oskitone/scout/kicad/keyboard_matrix/keyboard_matrix.kicad_pcb

## KiCad design kicad/keyboard_matrix/keyboard_matrix.kicad_pcb (2021-02-08)

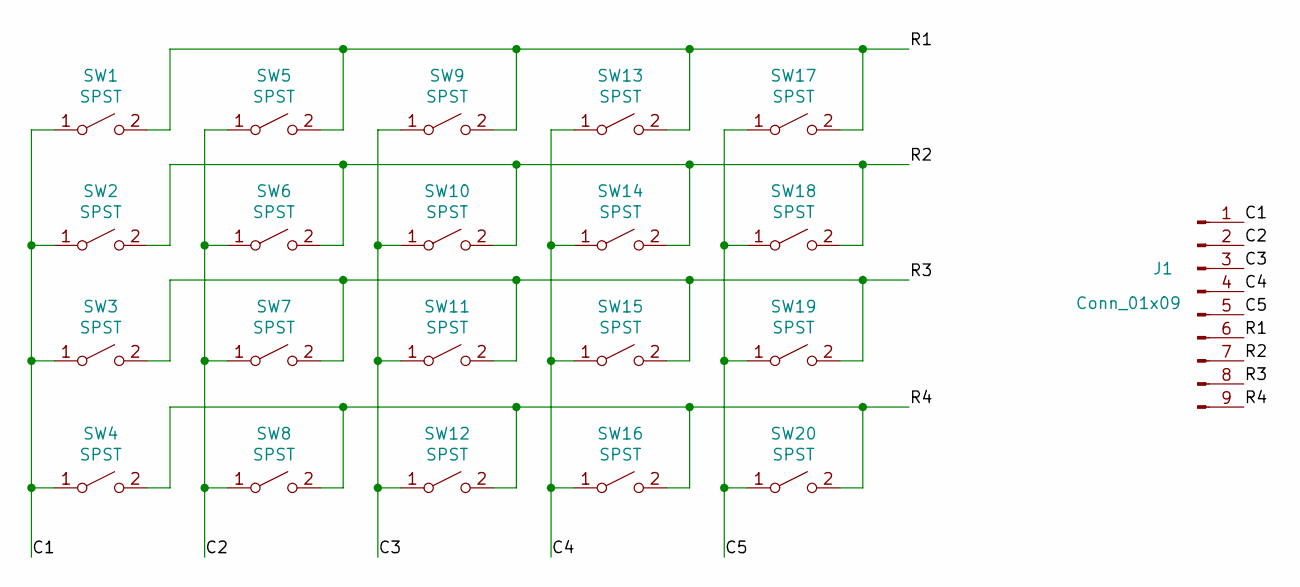
[picture p4: schematic keyboard_matrix.sch]

Parts:
J1: Conn_01x09; PinHeader_1x09_P2.54mm_Horizontal
SW1, SW2, SW3, SW4, SW5, SW6, SW7, SW8, SW9, SW10, SW11, SW12, SW13, SW14, SW15, SW16, SW17, SW18, SW19, SW20: SPST; SW_PUSH_6mm

Connections:
/C1: J1.1, SW1.1 (A), SW2.1 (A), SW3.1 (A), SW4.1 (A)
/C2: J1.2, SW5.1 (A), SW6.1 (A), SW7.1 (A), SW8.1 (A)
/C3: J1.3, SW9.1 (A), SW10.1 (A), SW11.1 (A), SW12.1 (A)
/C4: J1.4, SW13.1 (A), SW14.1 (A), SW15.1 (A), SW16.1 (A)
/C5: J1.5, SW17.1 (A), SW18.1 (A), SW19.1 (A), SW20.1 (A)
/R1: J1.6, SW1.2 (B), SW5.2 (B), SW9.2 (B), SW13.2 (B), SW17.2 (B)
/R2: J1.7, SW2.2 (B), SW6.2 (B), SW10.2 (B), SW14.2 (B), SW18.2 (B)
/R3: J1.8, SW3.2 (B), SW7.2 (B), SW11.2 (B), SW15.2 (B), SW19.2 (B)
/R4: J1.9, SW4.2 (B), SW8.2 (B), SW12.2 (B), SW16.2 (B), SW20.2 (B)

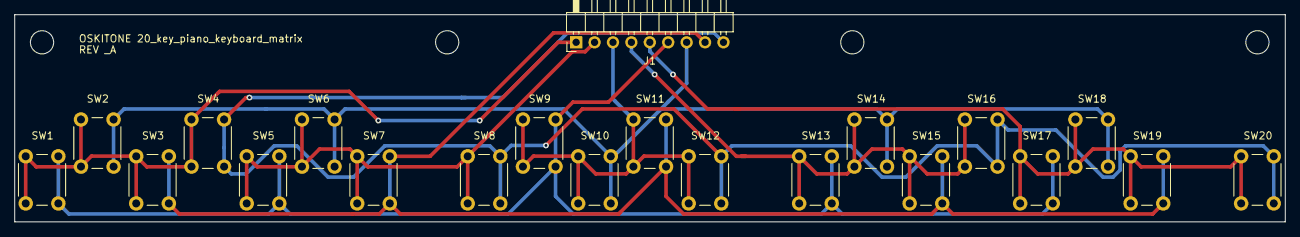
[picture p5: board keyboard_matrix.kicad_pcb from above]

Board: 2 copper layers, 175.3 x 28.6 mm, 25 parts (0 on the bottom side), 9 nets.

Other parts of the board:
 : 3.2mm; MountingHole_3.2mm_M3
 #2,  #3,  #4: 3.2mm; MountingHole_3.2mm_M3
