oskitone/scout/(notices)

Notices in the files:
kicad/scout/scout.kicad_pcb:
Designed by Oskitone. CC BY-SA 4.0.
